MatiPardoE/power-distribution-board/3dModel/minift_2x02.stp

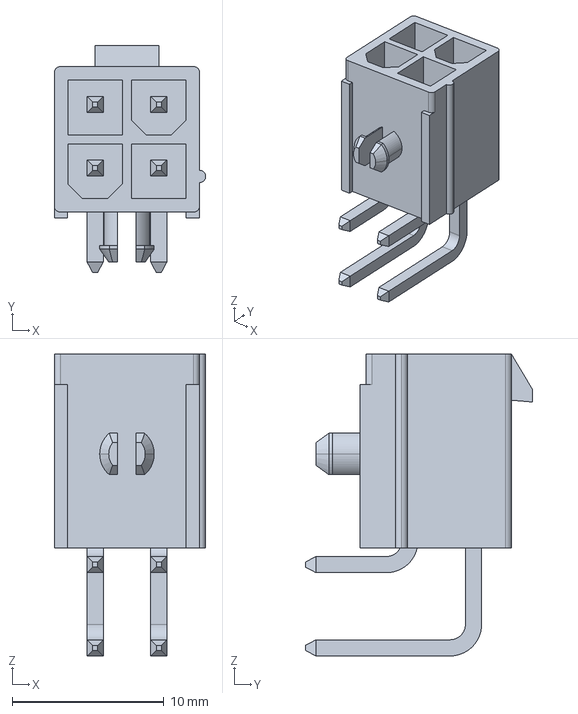
[picture p1: CAD file, 2026-02-15]
3dModel/minift_2x02.stp
10.0 x 15.0 x 19.9 mm
