MatiPardoE/power-distribution-board/3dModel/minifit2x12.stp

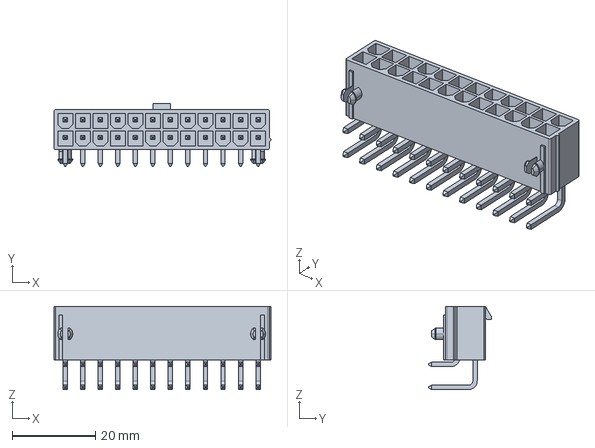
[picture p2: CAD file, 2026-02-15]
3dModel/minifit2x12.stp
52.0 x 15.0 x 19.9 mm
