MatiPardoE/power-distribution-board/3dModel/C44253.stp

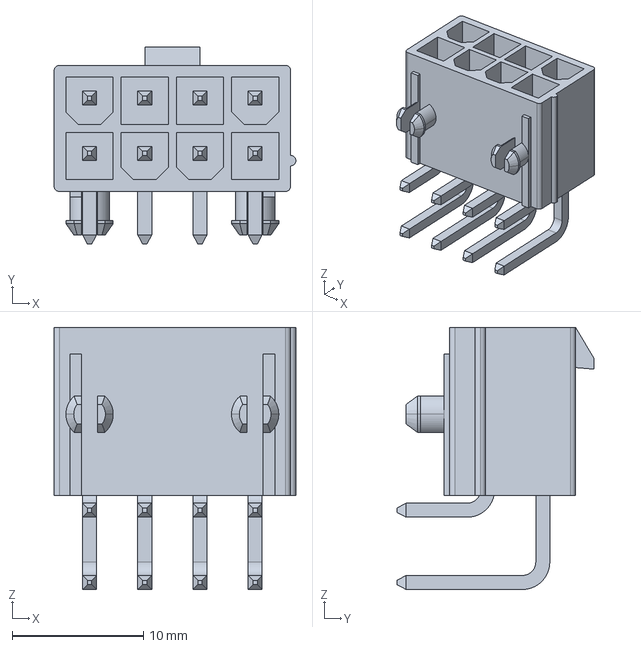
[picture p3: CAD file, 2026-02-15]
3dModel/C44253.stp
18.4 x 15.0 x 19.9 mm
