MatiPardoE/power-distribution-board/3dModel/C54904.stp

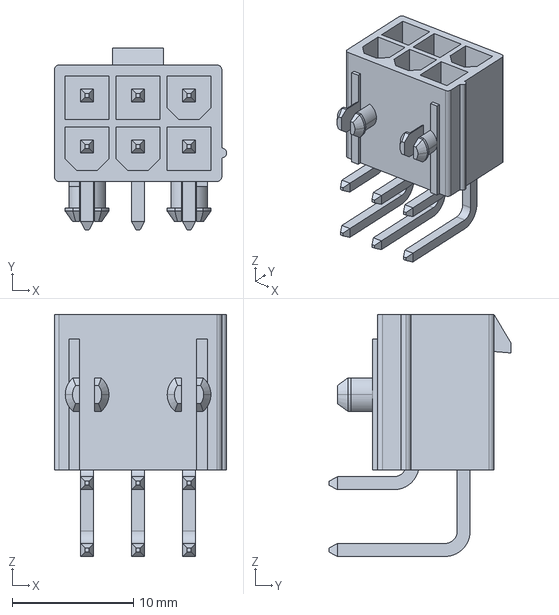
[picture p4: CAD file, 2026-02-15]
3dModel/C54904.stp
14.2 x 15.0 x 19.9 mm
