MatiPardoE/power-distribution-board/extra/pdb.pdf

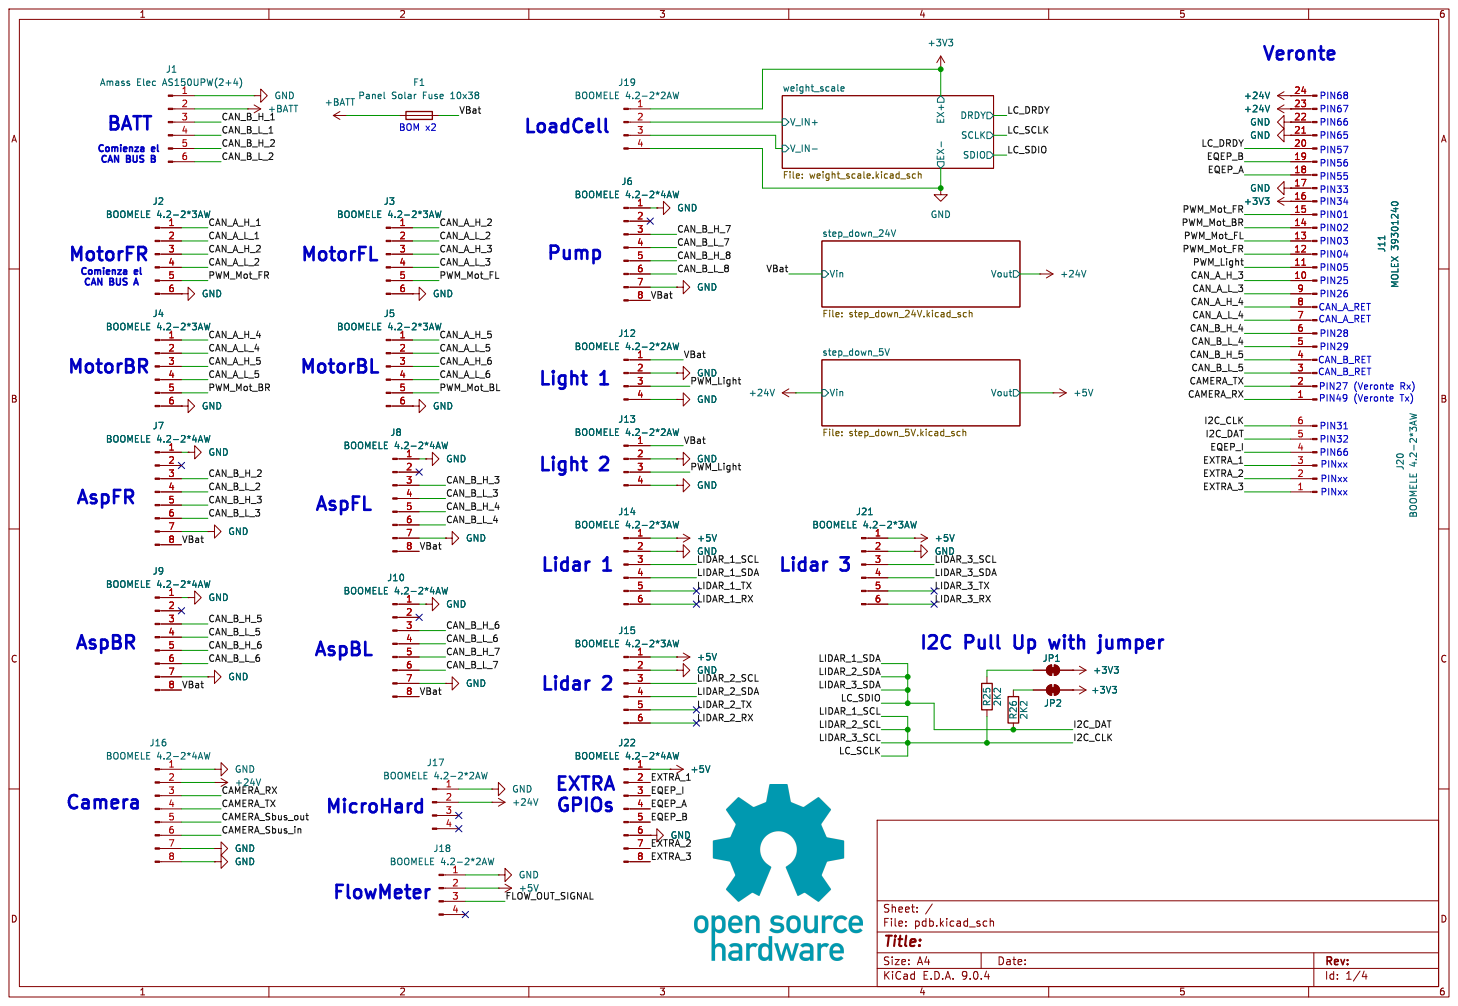
[picture p5: page 1]

Comienza el CAN BUS B AspFR

Id: 1/4 Title: File: pdb.kicad_sch Sheet: /

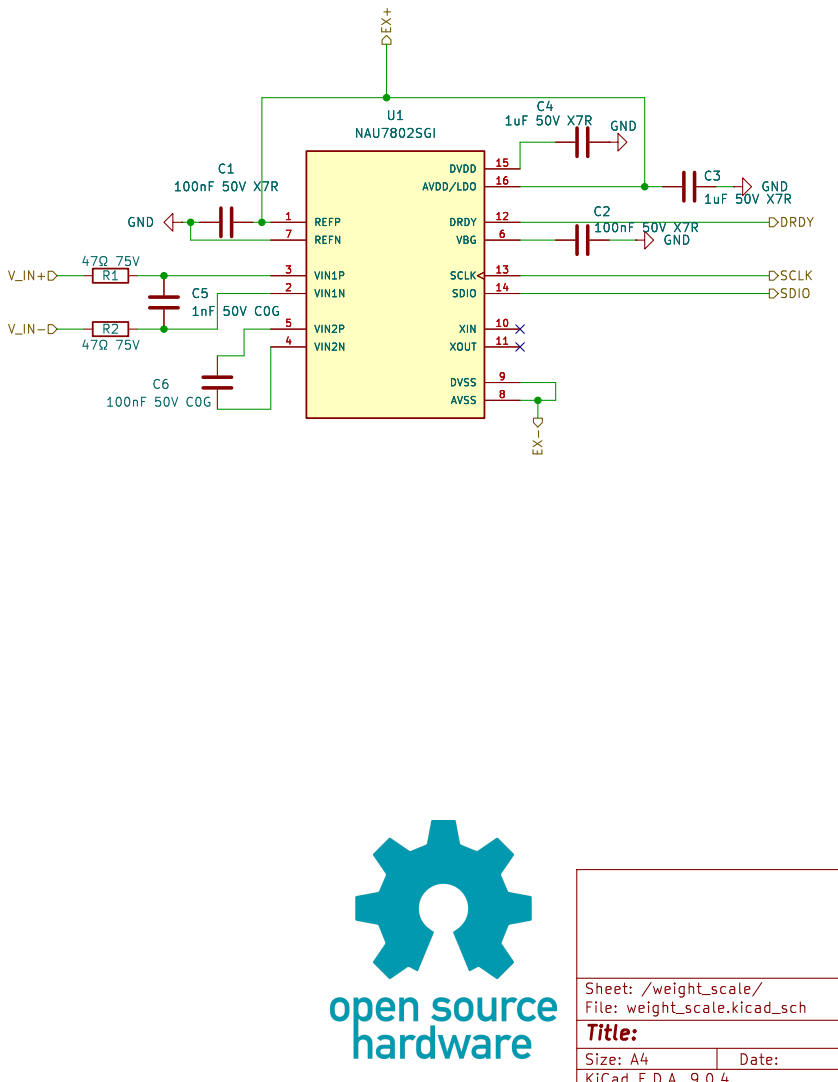
[picture p6: page 2]

Id: 2/4 Title: File: weight_scale.kicad_sch Sheet: /weight_scale/

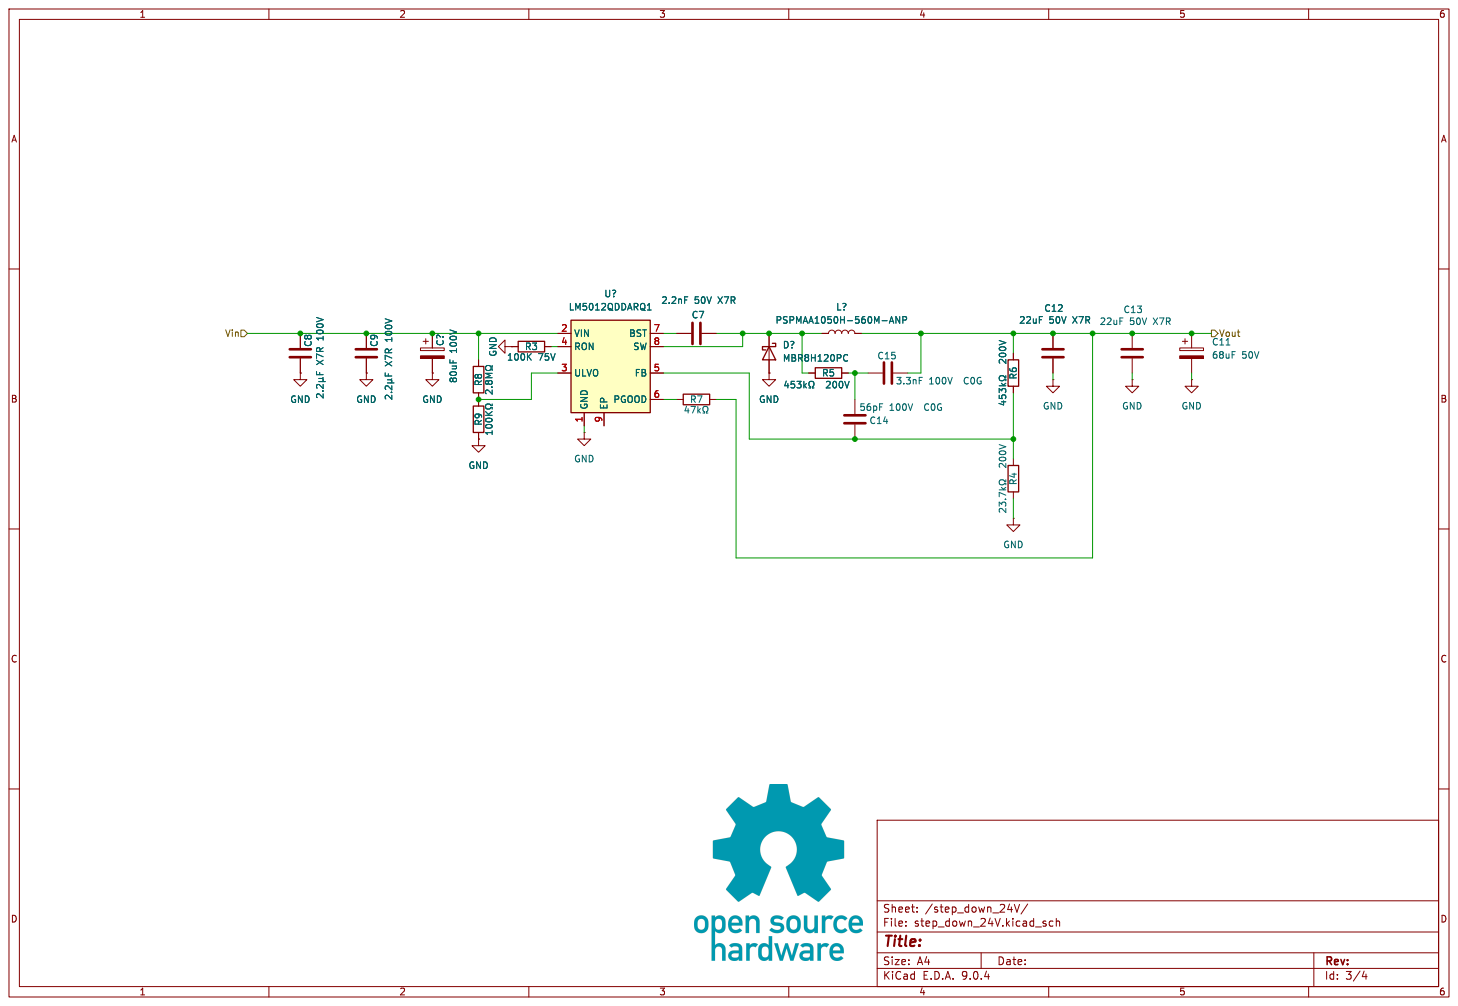
[picture p7: page 3]

9 BST 7 SW 8 FB 5 PGOOD 6 U?

9 BST 7 SW 8 FB 5 PGOOD 6 GND GND C9 þÿ2.2µFX7R 100V C? 80uF 100V C8 þÿ2.2µFX7R 100V GND GND R8 þÿ2.8M©R3

Id: 3/4 Title: File: step_down_24V.kicad_sch Sheet: /step_down_24V/

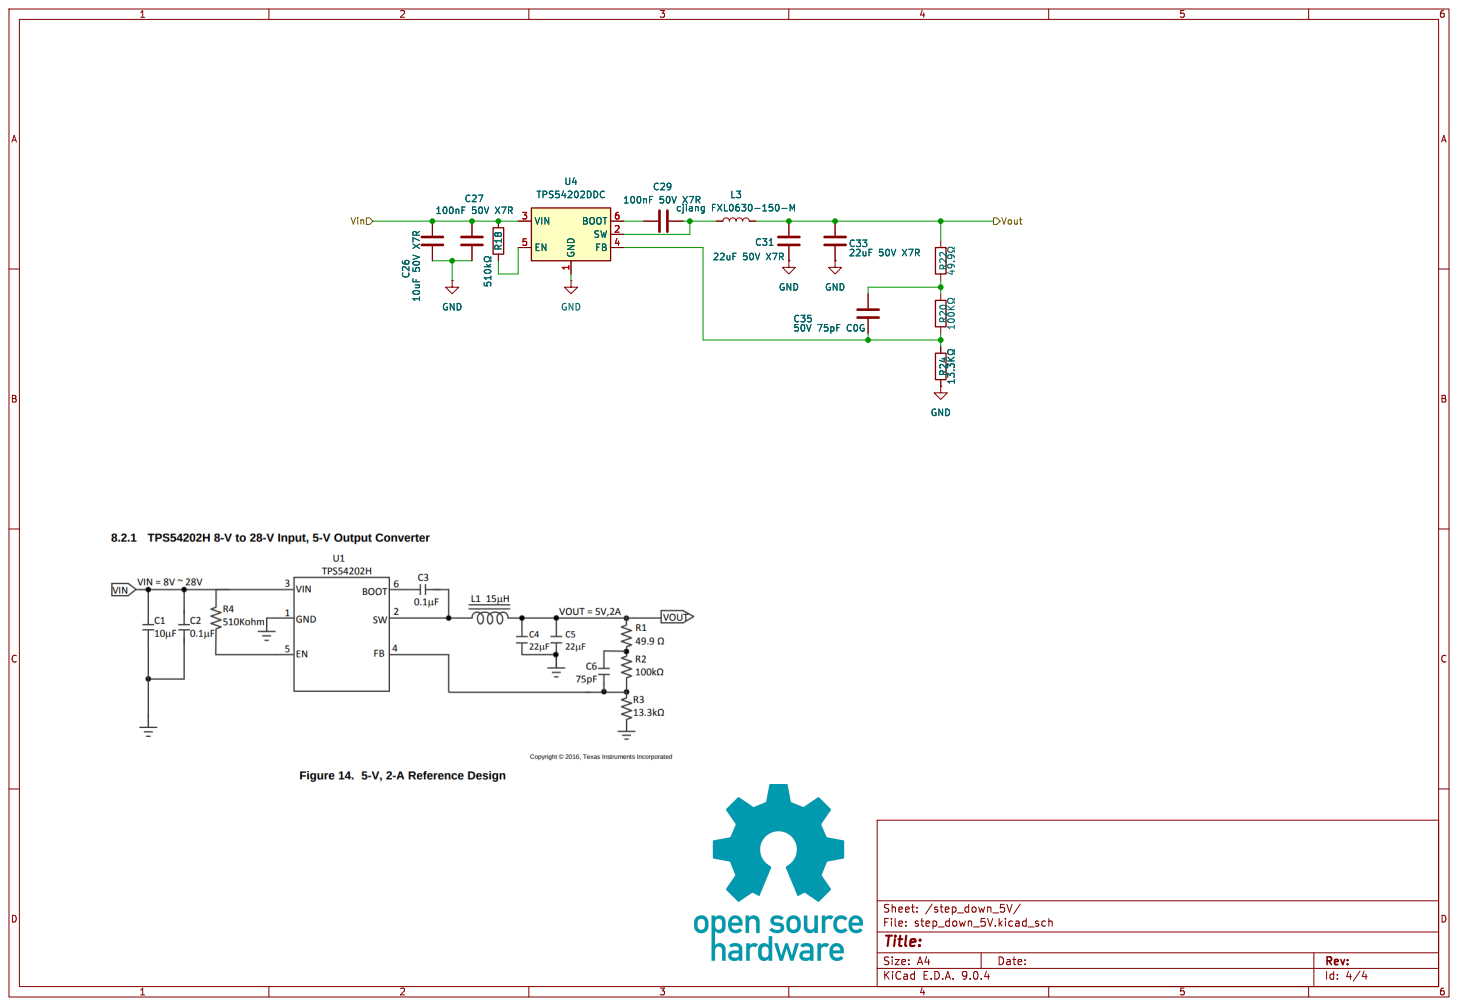
[picture p8: page 4]

1 BOOT 6 SW 2 FB 4 U4 TPS54202DDC R18 þÿ510k© R22 þÿ49.9© R20 þÿ100K© GND GND

1 BOOT 6 SW 2 FB 4 R18 þÿ510k© GND

Id: 4/4 Title: File: step_down_5V.kicad_sch Sheet: /step_down_5V/
