MatiPardoE/power-distribution-board/pdb.kicad_pcb

## KiCad design pdb.kicad_pcb (2026-02-18)

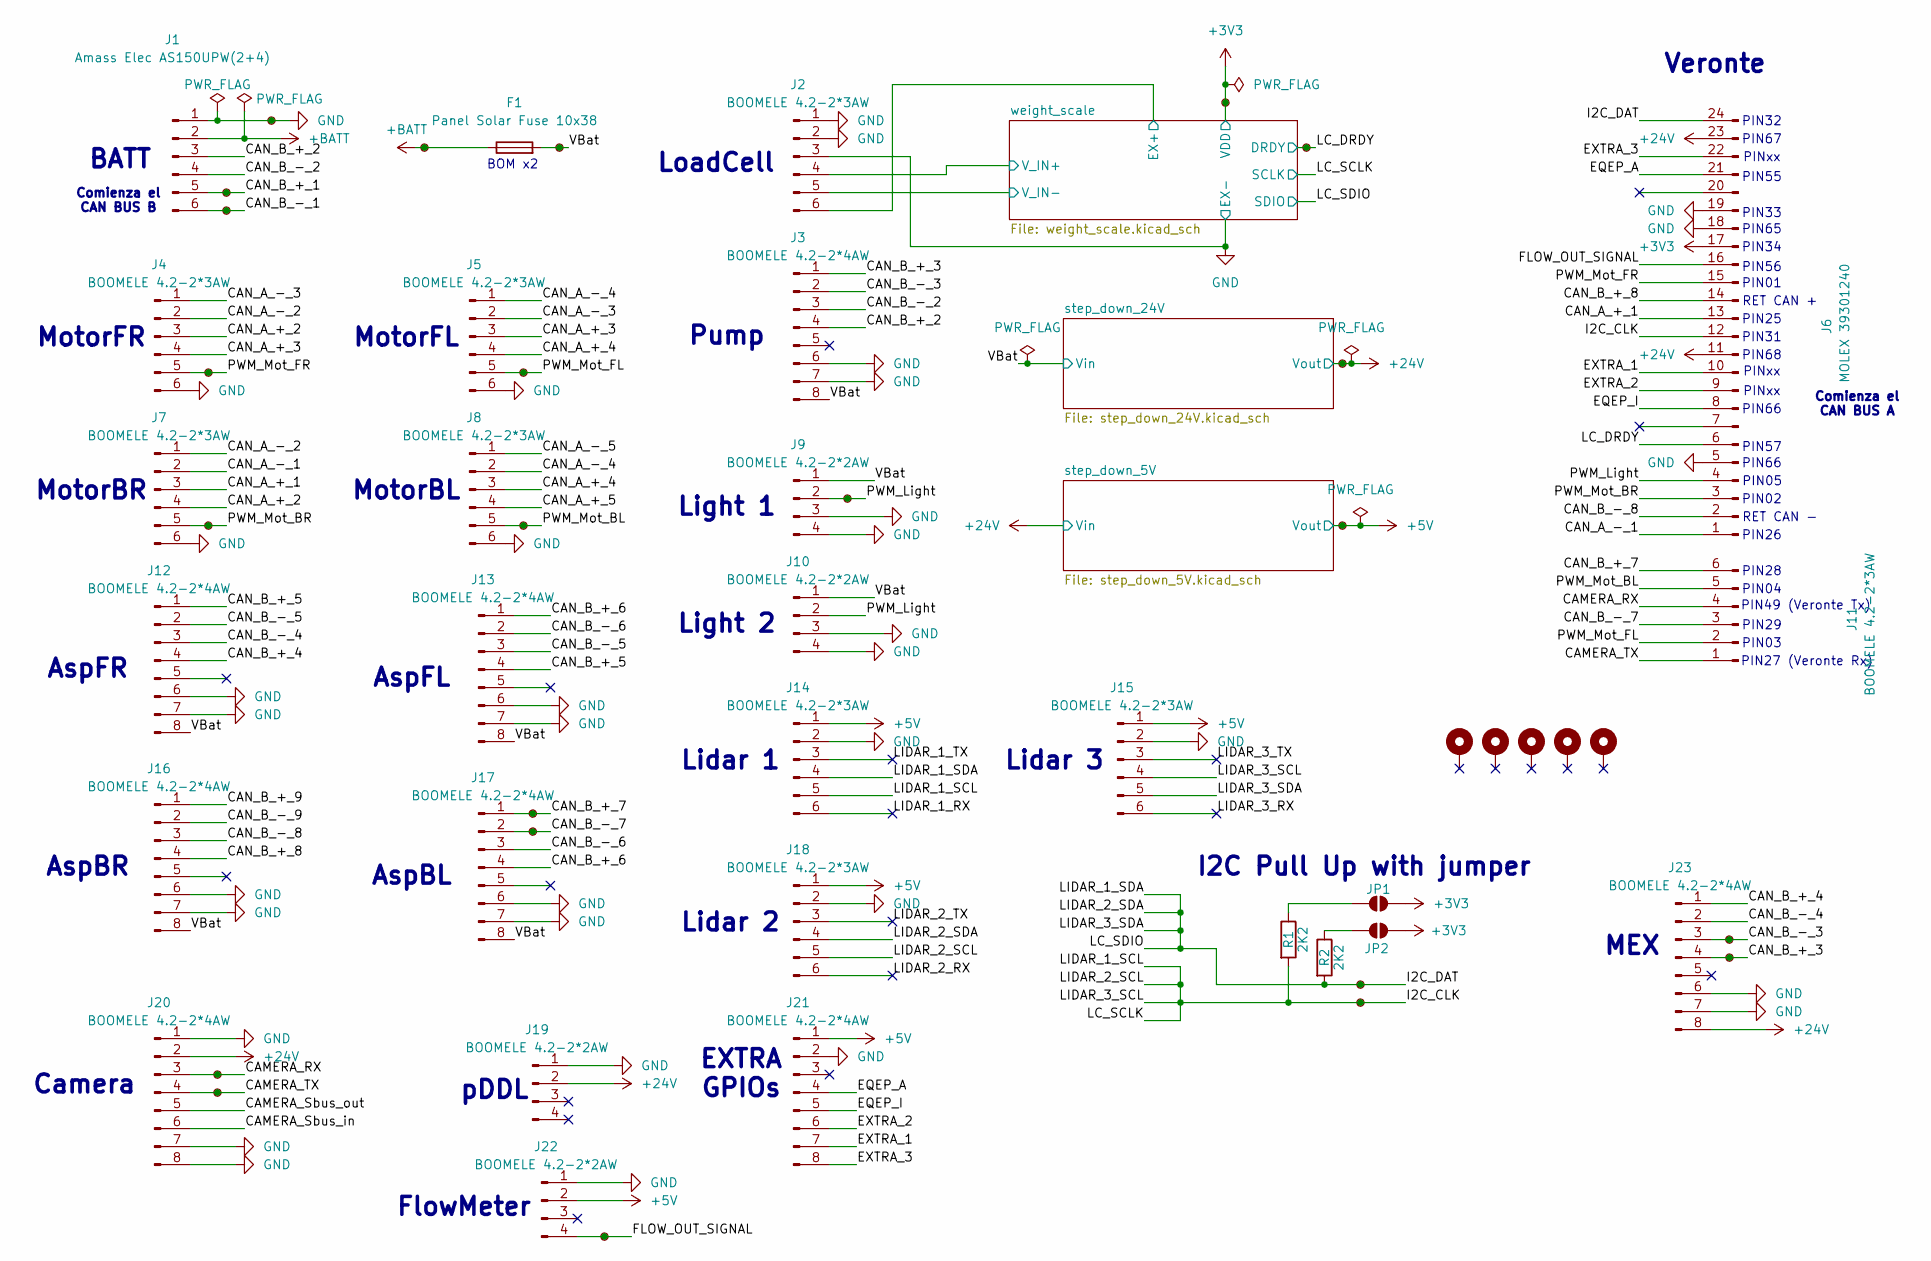
[picture p9: schematic pdb.kicad_sch]

Parts:
F1: Panel Solar Fuse 10x38; FUSE-HOLDER XFCN XF-008; LCSC Part # C717029
H1, H2, H3, H4, H5: MountingHole_Pad; MountingHole_3.2mm_M3_Pad_Via
J1: Amass Elec AS150UPW(2+4); CONN-TH_AS150UPW; LCSC Part # C19268054
J2, J4, J5, J7, J8, J11, J14, J15, J18: BOOMELE 4.2-2*3AW; Molex_Mini-Fit_Jr_5569-06A2_2x03_P4.20mm_Horizontal; LCSC Part # C54904
J3, J12, J13, J16, J17, J20, J21, J23: BOOMELE 4.2-2*4AW; Molex_Mini-Fit_Jr_5569-08A2_2x04_P4.20mm_Horizontal; LCSC Part # C44253
J6: MOLEX 39301240; Molex_Mini-Fit_Jr_5569-24A2_2x12_P4.20mm_Horizontal; LCSC Part # C492347
J9, J10, J19, J22: BOOMELE 4.2-2*2AW; Molex_Mini-Fit_Jr_5569-04A2_2x02_P4.20mm_Horizontal; LCSC Part # C54909
JP1, JP2: SolderJumper_2_Open; SolderJumper-2_P1.3mm_Open_TrianglePad1.0x1.5mm
R1, R2: 2K2; R_1206_3216Metric; LCSC Part # C2907443
TP1: +BATT; TestPoint_Pad_D2.0mm_silk_value
TP2: VBat; TestPoint_Pad_D2.0mm_silk_value
TP3: GND; TestPoint_Pad_D2.0mm_silk_value
TP4: CAN_B_+_1; TestPoint_Pad_D2.0mm_silk_value
TP5: CAN_B_-_1; TestPoint_Pad_D2.0mm_silk_value
TP8: CAN_B_+_7; TestPoint_Pad_D2.0mm_silk_value
TP9: CAN_B_-_7; TestPoint_Pad_D2.0mm_silk_value
TP12: CAM_RX; TestPoint_Pad_D2.0mm_silk_value
TP13: CAM_TX; TestPoint_Pad_D2.0mm_silk_value
TP14: PWM_MOT_FR; TestPoint_Pad_D2.0mm_silk_value
TP15: PWM_MOT_BR; TestPoint_Pad_D2.0mm_silk_value
TP16: PWM_MOT_BL; TestPoint_Pad_D2.0mm_silk_value
TP17: PWM_MOT_FL; TestPoint_Pad_D2.0mm_silk_value
TP18: FLOW_S; TestPoint_Pad_D2.0mm_silk_value
TP19: PWM_LIGHT; TestPoint_Pad_D2.0mm_silk_value
TP20: +24V; TestPoint_Pad_D2.0mm_silk_value
TP21: +5V; TestPoint_Pad_D2.0mm_silk_value
TP22: +3V3; TestPoint_Pad_D2.0mm_silk_value
TP23: I2C_DAT; TestPoint_Pad_D2.0mm_silk_value
TP24: I2C_CLK; TestPoint_Pad_D2.0mm_silk_value
TP27: LC_DRDY; TestPoint_Pad_D2.0mm_silk_value
TP28: CAN_B_-_3; TestPoint_Pad_D2.0mm_silk_value
TP29: CAN_B_+_3; TestPoint_Pad_D2.0mm_silk_value

Connections:
+3V3: J6.17, JP1.2 (B), JP2.2 (B), TP22.1; also elsewhere on the board
+5V: J14.1, J15.1, J18.1, J21.1, J22.2, TP21.1; also elsewhere on the board
+24V: J6.11, J6.23, J19.2, J20.2, J23.8, TP20.1; also elsewhere on the board
+BATT: F1.1, J1.2, TP1.1
/CAMERA_RX: J11.4, J20.3, TP12.1
/CAMERA_Sbus_in: J20.6
/CAMERA_Sbus_out: J20.5
/CAMERA_TX: J11.1, J20.4, TP13.1
/CAN_A_+_1: J6.13, J7.3
/CAN_A_+_2: J4.3, J7.4
/CAN_A_+_3: J4.4, J5.3
/CAN_A_+_4: J5.4, J8.3
/CAN_A_+_5: J8.4
/CAN_A_-_1: J6.1, J7.2
/CAN_A_-_2: J4.2, J7.1
/CAN_A_-_3: J4.1, J5.2
/CAN_A_-_4: J5.1, J8.2
/CAN_A_-_5: J8.1
/CAN_B_+_1: J1.5, TP4.1
/CAN_B_+_2: J1.3, J3.4
/CAN_B_+_3: J3.1, J23.4, TP29.1
/CAN_B_+_4: J12.4, J23.1
/CAN_B_+_5: J12.1, J13.4
/CAN_B_+_6: J13.1, J17.4
/CAN_B_+_7: J11.6, J17.1, TP8.1
/CAN_B_+_8: J6.14, J16.4
/CAN_B_+_9: J16.1
/CAN_B_-_1: J1.6, TP5.1
/CAN_B_-_2: J1.4, J3.3
/CAN_B_-_3: J3.2, J23.3, TP28.1
/CAN_B_-_4: J12.3, J23.2
/CAN_B_-_5: J12.2, J13.3
/CAN_B_-_6: J13.2, J17.3
/CAN_B_-_7: J11.3, J17.2, TP9.1
/CAN_B_-_8: J6.2, J16.3
/CAN_B_-_9: J16.2
/EQEP_A: J6.21, J21.4
/EQEP_I: J6.8, J21.5
/EXTRA_1: J6.10, J21.7
/EXTRA_2: J6.9, J21.6
/EXTRA_3: J6.22, J21.8
/FLOW_OUT_SIGNAL: J6.16, J22.4, TP18.1
/I2C_CLK: J6.12, J14.5, J15.4, J18.5, R1.2, TP24.1; also elsewhere on the board
/I2C_DAT: J6.24, J14.4, J15.5, J18.4, R2.2, TP23.1; also elsewhere on the board
/LC_DRDY: J6.6, TP27.1; also elsewhere on the board
/LIDAR_1_RX: J14.6
/LIDAR_1_TX: J14.3
/LIDAR_2_RX: J18.6
/LIDAR_2_TX: J18.3
/LIDAR_3_RX: J15.6
/LIDAR_3_TX: J15.3
/PWM_Light: J6.4, J9.2, J10.2, TP19.1
/PWM_Mot_BL: J8.5, J11.5, TP16.1
/PWM_Mot_BR: J6.3, J7.5, TP15.1
/PWM_Mot_FL: J5.5, J11.2, TP17.1
/PWM_Mot_FR: J4.5, J6.15, TP14.1
/VBat: F1.2, J3.8, J9.1, J10.1, J12.8, J13.8, J16.8, J17.8, TP2.1; also elsewhere on the board
/weight_scale/EX+: J2.6; also elsewhere on the board
/weight_scale/V_IN+: J2.4; also elsewhere on the board
/weight_scale/V_IN-: J2.5; also elsewhere on the board
GND: J1.1, J2.1, J2.2, J2.3, J3.6, J3.7, J4.6, J5.6, J6.5, J6.18, J6.19, J7.6, J8.6, J9.3, J9.4, J10.3, J10.4, J12.6, J12.7, J13.6, J13.7, J14.2, J15.2, J16.6, J16.7, J17.6, J17.7, J18.2, J19.1, J20.1, J20.7, J20.8, J21.2, J22.1, J23.6, J23.7, TP3.1; also elsewhere on the board
unnamed: JP1.1 (A), R1.1
unnamed: JP2.1 (A), R2.1

Notes on the sheet:
AspBR
FlowMeter
PIN66
PIN49 (Veronte Tx)
AspFR
PIN02
AspFL
PIN33
PIN01
PIN67
PIN56
PIN68
PINxx
Lidar 3
Light 1
Comienza el CAN BUS A
LoadCell
Lidar 1
I2C Pull Up with jumper
pDDL
MotorBR
Lidar 2
EXTRA GPIOs
Comienza el CAN BUS B
MotorBL
PIN32
PIN04
PIN57
PIN29
PIN31
MotorFR
MEX
PIN26
PIN27 (Veronte Rx)
PIN05
PIN28
Pump
Veronte
PIN55
Camera
PIN34
PIN65
Light 2
BOM x2
PIN03
AspBL
RET CAN -
PIN25
BATT
MotorFL
RET CAN +

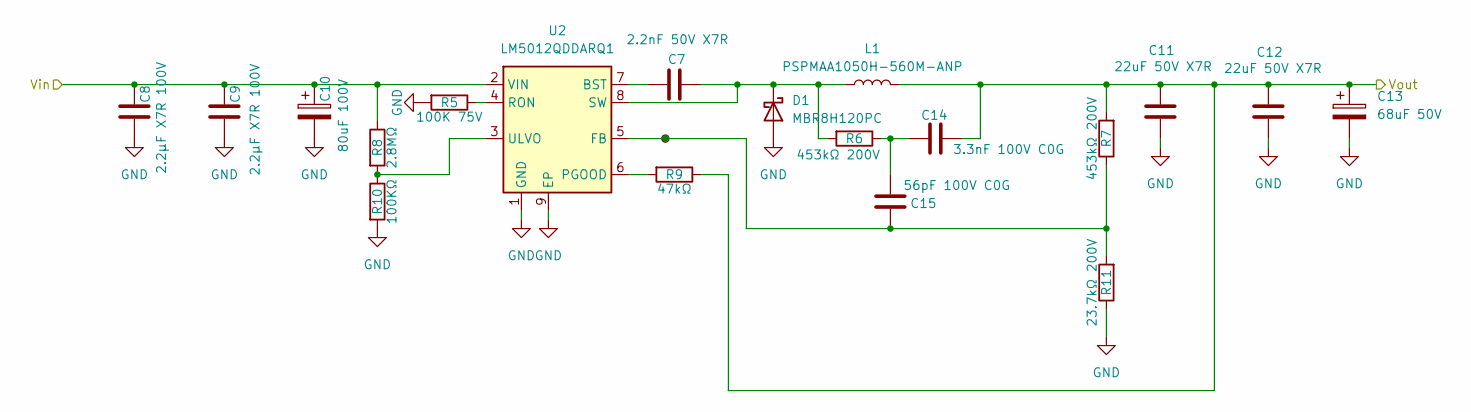
[picture p10: schematic step_down_24V.kicad_sch]

Parts:
C7: 2.2nF 50V X7R; C_0603_1608Metric; LCSC Part # C86023
C8, C9: 2.2µF X7R 100V; C_1206_3216Metric; LCSC Part # C577211
C10: 80uF 100V; CP_Elec_10x10.5; LCSC Part # C22387789
C11, C12: 22uF 50V X7R; C_1812_4532Metric; LCSC Part # C22388553
C13: 68uF 50V; CP_Elec_6.3x7.7; LCSC Part # C5221836
C14: 3.3nF 100V C0G; C_1206_3216Metric; LCSC Part # C2915710
C15: 56pF 100V C0G; C_0603_1608Metric; LCSC Part # C490535
D1: MBR8H120PC; TO-277C; LCSC Part # C19845038
L1: PSPMAA1050H-560M-ANP; L_Sunlord_MWSA1005S; LCSC Part # C5273831
R5: 100K 75V; R_0603_1608Metric; LCSC Part # C25803
R6, R7: 453kΩ 200V; R_1206_3216Metric; LCSC Part # C2085565
R8: 2.8MΩ; R_1206_3216Metric; LCSC Part # C488723
R9: 47kΩ; R_0805_2012Metric; LCSC Part # C17713
R10: 100KΩ; R_1206_3216Metric; LCSC Part # C17900
R11: 23.7kΩ 200V; R_1206_3216Metric; LCSC Part # C2085565
TP25: FB_24V; TestPoint_Pad_D2.0mm_silk_value
U2: LM5012QDDARQ1; SOIC-8-1EP_3.9x4.9mm_P1.27mm_EP2.95x4.9mm_Mask2.71x3.4mm_Th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; LCSC Part # C5451792

Connections:
+24V: C11.2, C12.2, C13.1, C14.1, L1.2, R7.2, R9.1; also elsewhere on the board
/VBat: C8.1, C9.1, C10.1, R8.1, U2.2 (VIN); also elsewhere on the board
GND: C8.2, C9.2, C10.2, C11.1, C12.1, C13.2, D1.2 (A), R5.2, R10.2, R11.1, U2.1 (GND), U2.9 (EP); also elsewhere on the board
unnamed: C14.2, C15.1, R6.1
unnamed: C7.2, D1.1 (K), L1.1, R6.2, U2.8 (SW)
unnamed: C7.1, U2.7 (BST)
unnamed: C15.2, R7.1, R11.2, TP25.1, U2.5 (FB)
unnamed: R9.2, U2.6 (PGOOD)
unnamed: R5.1, U2.4 (RON)
unnamed: R8.2, R10.1, U2.3 (ULVO)

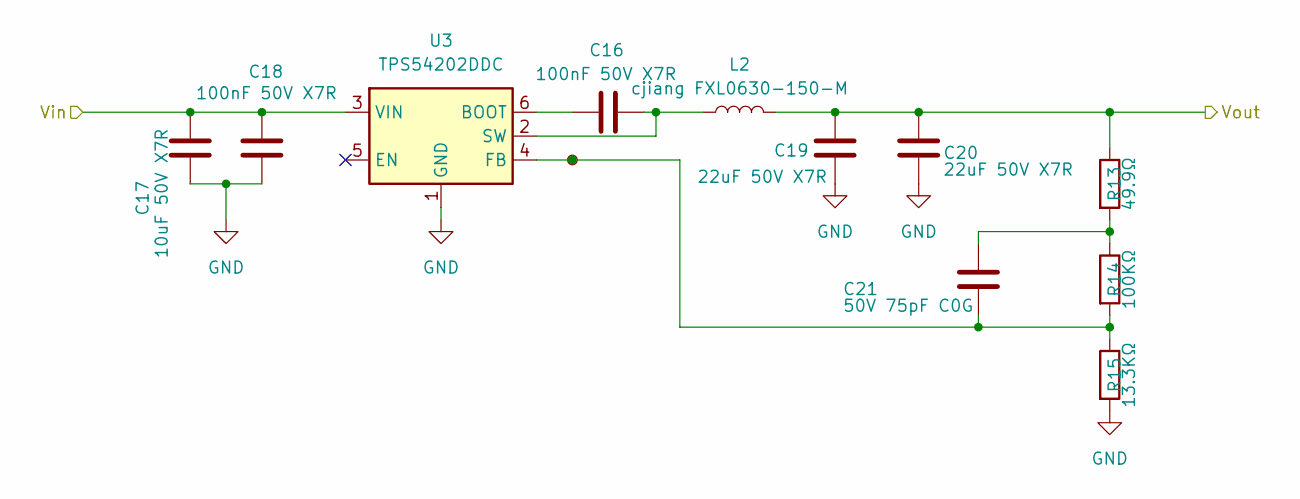
[picture p11: schematic step_down_5V.kicad_sch]

Parts:
C16, C18: 100nF 50V X7R; C_0603_1608Metric; LCSC Part # C14663
C17: 10uF 50V X7R; C_1206_3216Metric; LCSC Part # C89632
C19, C20: 22uF 50V X7R; C_1812_4532Metric; LCSC Part # C22388553
C21: 50V 75pF C0G; C_0603_1608Metric; LCSC Part # C1681
L2: cjiang FXL0630-150-M; L_Sunlord_MWSA0624S; LCSC Part # C177243
R13: 49.9Ω; R_1206_3216Metric; LCSC Part # C18018
R14: 100KΩ; R_1206_3216Metric; LCSC Part # C728669
R15: 13.3KΩ; R_1206_3216Metric; LCSC Part # C870412
TP26: FB_5V; TestPoint_Pad_D2.0mm_silk_value
U3: TPS54202DDC; SOT-23-6

Connections:
+5V: C19.2, C20.2, L2.2, R13.1; also elsewhere on the board
+24V: C17.2, C18.1, U3.3 (VIN); also elsewhere on the board
GND: C17.1, C18.2, C19.1, C20.1, R15.2, U3.1 (GND); also elsewhere on the board
unnamed: C21.2, R13.2, R14.1
unnamed: C16.1, U3.6 (BOOT)
unnamed: C21.1, R14.2, R15.1, TP26.1, U3.4 (FB)
unnamed: C16.2, L2.1, U3.2 (SW)

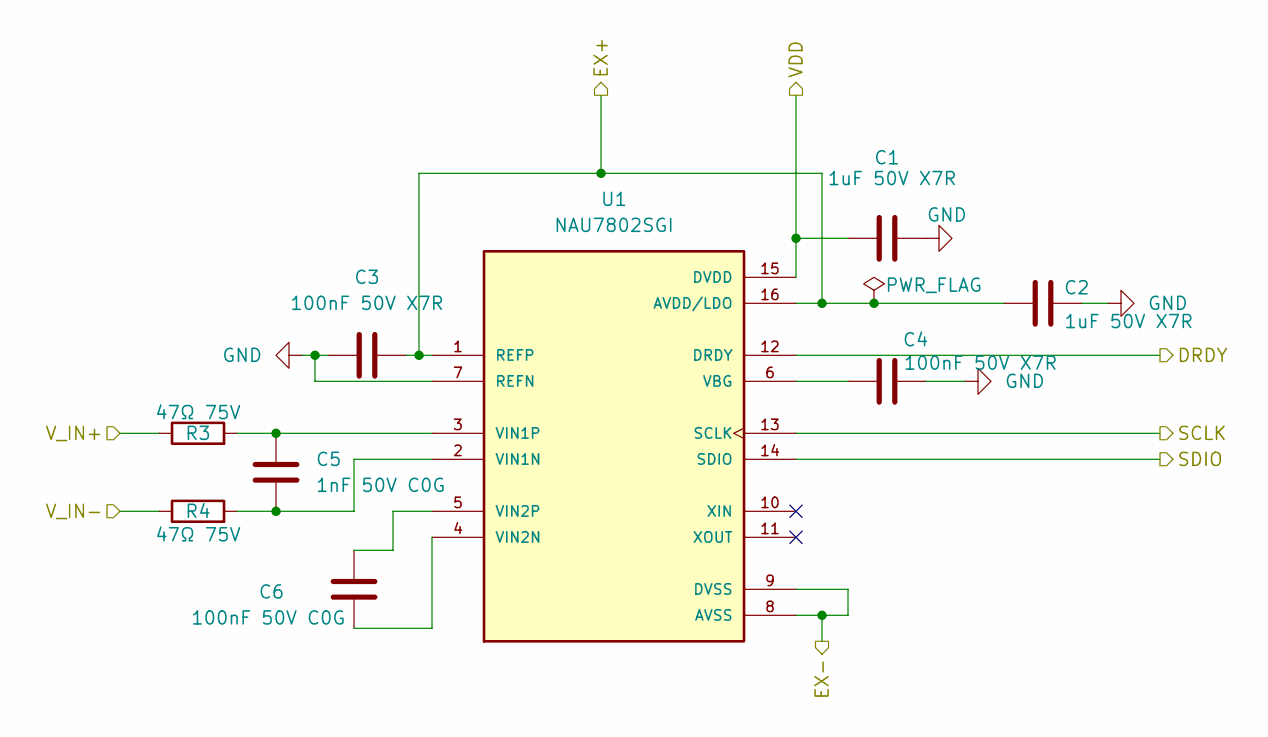
[picture p12: schematic weight_scale.kicad_sch]

Parts:
C1, C2: 1uF 50V X7R; C_0603_1608Metric; LCSC Part # C5199872
C3, C4: 100nF 50V X7R; C_0603_1608Metric; LCSC Part # C14663
C5: 1nF 50V C0G; C_0603_1608Metric; LCSC Part # C163508
C6: 100nF 50V C0G; C_1206_3216Metric; LCSC Part # C97946
R3, R4: 47Ω 75V; R_0603_1608Metric; LCSC Part # C1211
U1: NAU7802SGI; SOIC-16_3.9x9.9mm_P1.27mm; PARTREV 2.6; LCSC Part # C2614351

Connections:
+3V3: C1.1, U1.15 (DVDD); also elsewhere on the board
/I2C_CLK: U1.13 (SCLK); also elsewhere on the board
/I2C_DAT: U1.14 (SDIO); also elsewhere on the board
/LC_DRDY: U1.12 (DRDY); also elsewhere on the board
/weight_scale/EX+: C2.2, C3.1, U1.1 (REFP), U1.16 (AVDD/LDO); also elsewhere on the board
/weight_scale/V_IN+: R3.1; also elsewhere on the board
/weight_scale/V_IN-: R4.1; also elsewhere on the board
GND: C1.2, C2.1, C3.2, C4.2, U1.7 (REFN), U1.8 (AVSS), U1.9 (DVSS); also elsewhere on the board
unnamed: C4.1, U1.6 (VBG)
unnamed: C5.2, R4.2, U1.2 (VIN1N)
unnamed: C5.1, R3.2, U1.3 (VIN1P)
unnamed: C6.1, U1.4 (VIN2N)
unnamed: C6.2, U1.5 (VIN2P)

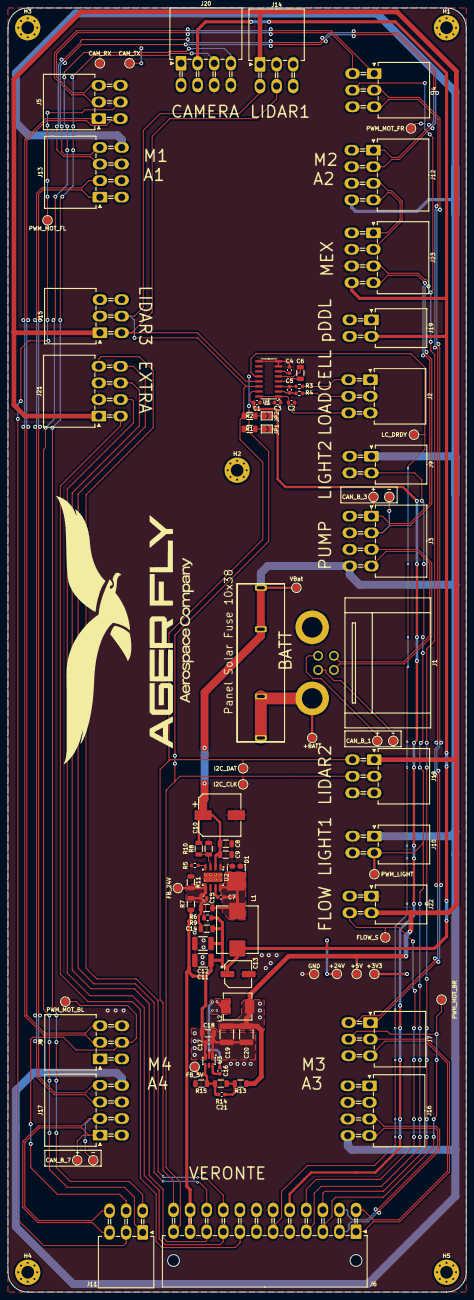
[picture p13: board pdb.kicad_pcb from above]

Board: 2 copper layers, 116.0 x 325.0 mm, 97 parts (0 on the bottom side), 67 nets.
