MatiPardoE/power-distribution-board/(commit log)

2026-01-25 first commit branch
    [pdb.kicad_sch]
2026-01-26 ADD: Mas conectores al esquematico y fuse holder para 10x38
    [pdb.kicad_sch]
2026-01-29 Esquematico casi terminado falta agregar el veronte
    [pdb.kicad_pcb, pdb.kicad_sch, step_down.kicad_sch, weight_scale.kicad_sch]
2026-01-30 ADD: Fuente de 24V a 5V para los Lidar
    [pdb.kicad_pcb, pdb.kicad_sch, step_down.kicad_sch]
2026-02-05 ADD: Terminado la fuente de 24V a 5V, terminado los pines del veronte y tambien el circuito de I2C
    [pdb.kicad_sch, step_down_24V.kicad_sch, step_down_5V.kicad_sch, weight_scale.kicad_sch]
2026-02-05 FIX: Sensor de flujo en EQ
    [pdb.kicad_sch]
2026-02-15 Primer sesion de ruteo
    [C44253.stp, C54904.stp, minifit2x12.stp, minift_2x02.stp, pdb.kicad_pcb, pdb.kicad_sch, step_down_24V.kicad_sch, step_down_5V.kicad_sch]
2026-02-18 Agregado los testpoint, falta leds indicadores y serigrafia y cerramos
    [pdb.kicad_pcb, pdb.kicad_sch, step_down_24V.kicad_sch, step_down_5V.kicad_sch]
